Kanomace/WiFi-servo-controller/Cloud Server/MQTTX_setting/Example.png

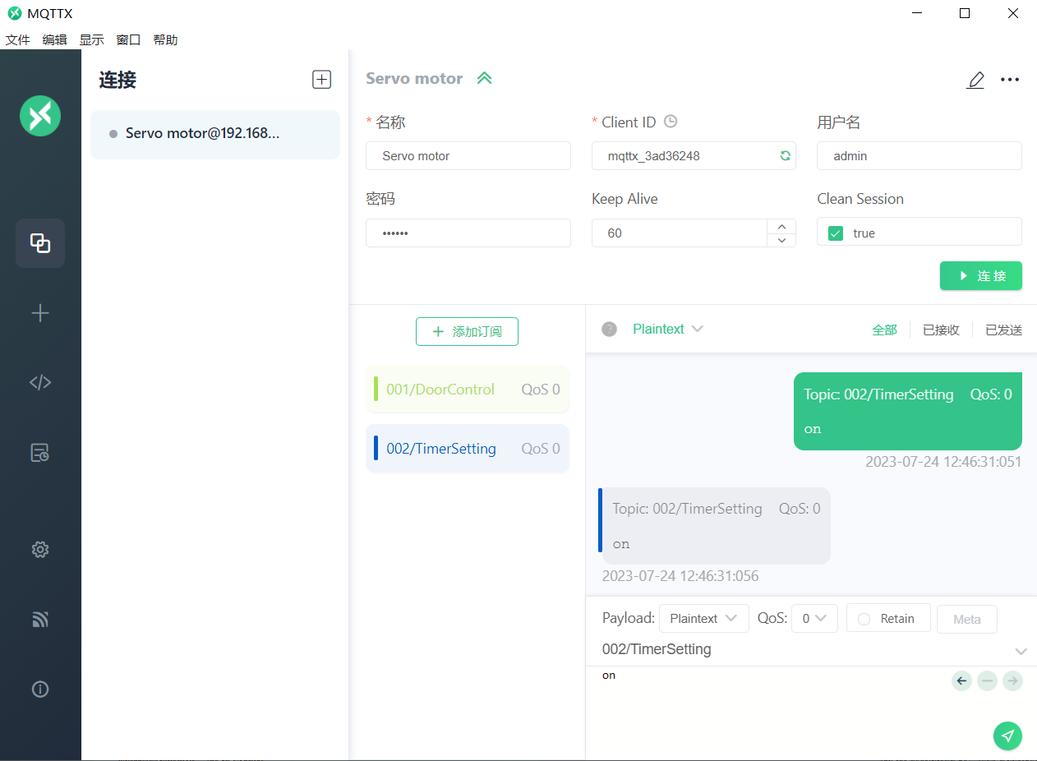
Cloud Server/MQTTX_setting/Example.png
