Kanomace/WiFi-servo-controller/Hardware/BOM_V1_2023-08-09.xlsx

No. | Quantity | Comment | Designator | Footprint | Value | Manufacturer Part | Manufacturer | Supplier Part | Supplier | LCSC Price
1 | 2 | Value +&apos; &apos;+ Voltage + &apos; &apos; + Type | C1,C5 | CAPC1608[0603]S-N | 100nF
2 | 1 | Value +&apos; &apos;+ Voltage + &apos; &apos; + Type | C2 | CAP-E-S 6.3 | 220uF
3 | 1 | Value +&apos; &apos;+ Voltage + &apos; &apos; + Type | C3 | CAPC3216[1206]S | 47uF
4 | 1 | Value +&apos; &apos;+ Voltage + &apos; &apos; + Type | C4 | CAP-E-S 6.3 | 100uF
5 | 1 | Value +&apos; &apos;+ Voltage + &apos; &apos; + Type | C6 | CAPC3216[1206]S | 4.7uF
6 | 1 | Value +&apos; &apos;+ Voltage + &apos; &apos; + Type | C7 | CAPC1608[0603]S-N | 4.7nF
7 | 2 | 10uF | C17,C20 | C0805 | 10uF | GRM21BR61H106KE43L | muRata(村田) | C440198 | LCSC | 0.489247
8 | 2 | 104 | C18,C19 | C0603
9 | 2 | SS54 | D1,D4 | SMA-L[DO-214AC] | SS54
10 | 1 | SS14 | D2 | SOD-123FL_L2.8-W1.8-LS3.7-RD |  | SS14 | KUU | C2909920 | LCSC | 0.085868
11 | 2 | LED | D3,D8 | LED-0805R
12 | 1 | 1N4007 | D7 | SOD-123-L
13 | 2 | TSA343G00-250J2 | EN1,EN2 | SW-SMD_L4.0-W2.9-LS5.0 |  | TSA343G00-250J2 | BRIGHT(博瑞泰) | C354946 | LCSC | 0.309749
14 | 1 | PZ254V-11-08P | H3 | HDR-TH_8P-P2.54-V-M |  | PZ254V-11-08P | XFCN(兴飞) | C492407 | LCSC | 0.249309
15 | 3 | PZ254V-11-03P | H4,H5,H6 | HDR-TH_3P-P2.54-V-M |  | PZ254V-11-03P | XFCN(兴飞) | C2937625 | LCSC | 0.101746
16 | 1 | PZ254V-11-04P | H7 | HDR-TH_4P-P2.54-V-M |  | PZ254V-11-04P | XFCN(兴飞) | C2691448 | LCSC | 0.135871
17 | 1 | Value + &apos; &apos; + Imax | L1 | 0630 TPC 7*7*3 | 4.7uH
18 | 1 | WS2812B-V5/W | LED2 | LED-SMD_L5.0-W5.0-P3.20-LS5.4-TL |  | WS2812B-V5/W | worldsemi | C2874885 | LCSC | 0.681617
19 | 2 | S8050 | Q1,Q2 | SOT-23-3_L2.9-W1.3-P1.90-LS2.4-BR |  | S8050 | WPMtek(维攀微) | C2688231 | LCSC | 0.068462
20 | 1 | AO3402 | Q3 | SOT-23
21 | 1 | Value+&apos; &apos;+Tolerance | R1 | RESC1608[0603]S-N | 51K
22 | 1 | Value+&apos; &apos;+Tolerance | R2 | RESC1608[0603]S-N | 4.7K
23 | 1 | Value+&apos; &apos;+Tolerance | R3 | RESC1608[0603]S-N | 1.5K
24 | 1 | Value+&apos; &apos;+Tolerance | R4 | RESC1608[0603]S-N | 200K
25 | 1 | Value+&apos; &apos;+Tolerance | R5 | RESC1608[0603]S-N | 10K
26 | 1 | Value+&apos; &apos;+Tolerance | R6 | RESC1608[0603]S-N | 20K
27 | 1 | 0Ω | R8 | R0603 | 0Ω | 0603WAF0000T5E | UNI-ROYAL(厚声) | C21189 | LCSC | 0.006582
28 | 1 | 4.7kΩ | R9 | R0603 | 4.7kΩ | 0603WAF4701T5E | UNI-ROYAL(厚声) | C23162 | LCSC | 0.006586
29 | 4 | 1kΩ | R10,R11,R28,R35 | R0603 | 1kΩ | 0603WAF1001T5E | UNI-ROYAL(厚声) | C21190 | LCSC | 0.00351
30 | 4 | 10kΩ | R24,R25,R26,R27 | R0603 | 10kΩ | 0603WAF1002T5E | UNI-ROYAL(厚声) | C25804 | LCSC | 0.005483
31 | 1 | Value+&apos; &apos;+Tolerance | R34 | RESC1608[0603]S-N | 100R
32 | 1 | RELAY | RELAY1 | RELAY-15x10x12
33 | 1 | KH-TYPE-C-16P | TYPE-C1 | USB-C-SMD_KH-TYPE-C-16P |  | KH-TYPE-C-16P | kinghelm(金航标) | C709357 | LCSC | 0.511
34 | 1 | SP1N28STER | U2 | SOP-8E | SP1N28STER
35 | 1 | AMS1117-3.3 | U3 | SOT-89-3_L4.5-W2.5-P1.50-LS4.2-BR |  | AMS1117-3.3 | Slkor(萨科微) | C880752 | LCSC | 0.27159
36 | 1 | CP2102 | U7 | WQFN-28_L5.0-W5.0-P0.50-BL-EP3.2 |  | CP2102 | SILICON LABS(芯科) | C6568 | LCSC | 13.5
37 | 1 | ESP32-WROOM-32D | U8 | WIFIM-SMD_ESP32-WROOM-32D |  | ESP32-WROOM-32D |  | C503588 | LCSC
38 | 1 | 7.2kΩ | U9 | R0603 | 7.2kΩ | AR03FTDX7201NA | Viking(光颉) | C2924153 | LCSC | 0.082603
39 | 2 | KF/WJ/DG 30x connecter | 端子1,端子2 | KF/WJ/DG 301-2p-5.0mm
