Kanomace/WiFi-servo-controller/Cloud Server/MQTTX_setting/个人热点版本.xlsx

id | clientId | name | clean | protocol | host | port | keepalive | connectTimeout | reconnect | reconnectPeriod | username | password | path | certType | ssl | mqttVersion | unreadMessageCount | clientIdWithTime | parentId | orderId | rejectUnauthorized | ca | cert | key | isCollection | createAt | updateAt | sessionExpiryInterval | receiveMaximum | maximumPacketSize | topicAliasMaximum | requestResponseInformation | requestProblemInformation | userProperties | authenticationMethod | authenticationData | pushPropsPayloadFormatIndicator | pushPropsMessageExpiryInterval | pushPropsTopicAlias | pushPropsResponseTopic | pushPropsCorrelationData | pushPropsUserProperties | pushPropsSubscriptionIdentifier | pushPropsContentType | messages | subscriptions | will | properties
01d8d247-3361-47cc-b64b-676d72b897c0 | mqttx_3ad36248 | Servo motor | TRUE | mqtt | 192.168.202.86 | 1883 | 60 | 10 | FALSE | 4000 | admin | public | /mqtt |  | FALSE | 3.1.1 | 0 | FALSE |  |  | TRUE |  |  |  | FALSE | 2023-07-24 | 2023-08-10 | 0 |  |  |  |  |  |  |  |  |  |  |  |  |  |  |  |  | [{"id":"message_010baf29-1d7a-4095-9a20-c25273d7eb77","createAt":"2023-07-24 09:51:23:920","out":true,"payload":"{\n \"msg\": \"hello\"\n}","qos":0,"retain":false,"topic":"/topic/qos1","meta":null,"payloadFormatIndicator":null,"messageExpiryInterval":null,"topicAlias":null,"responseTopic":null,"correlationData":null,"userProperties":null,"subscriptionIdentifier":null,"contentType":null,"connectionId":"01d8d247-3361-47cc-b64b-676d72b897c0","properties":{"id":"message_010baf29-1d7a-4095-9a20-c25273d7eb77","createAt":"2023-07-24 09:51:23:920","out":true,"payload":"{\n \"msg\": \"hello\"\n}","qos":0,"retain":false,"topic":"/topic/qos1","meta":null,"payloadFormatIndicator":null,"messageExpiryInterval":null,"topicAlias":null,"responseTopic":null,"correlationData":null,"subscriptionIdentifier":null,"contentType":null,"connectionId":"01d8d247-3361-47cc-b64b-676d72b897c0"}},{"id":"message_b9f6697a-188c-4174-be61-1b66a67af96d","createAt":"2023-07-24 09:51:24:403","out":true,"payload":"{\n \"msg\": \"hello\"\n}","qos":0,"retain":false,"topic":"/topic/qos1","meta":null,"payloadFormatIndicator":null,"messageExpiryInterval":null,"topicAlias":null,"responseTopic":null,"correlationData":null,"userProperties":null,"subscriptionIdentifier":null,"contentType":null,"connectionId":"01d8d247-3361-47cc-b64b-676d72b897c0","properties":{"id":"message_b9f6697a-188c-4174-be61-1b66a67af96d","createAt":"2023-07-24 09:51:24:403","out":true,"payload":"{\n \"msg\": \"hello\"\n}","qos":0,"retain":false,"to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 | [{"id":"scription_5e358d23-725f-4dc8-baea-258029589950","topic":"002/TimerSetting","qos":0,"disabled":false,"alias":"","retain":false,"nl":false,"rap":false,"rh":0,"subscriptionIdentifier":null,"userProperties":null,"color":"#005DC6","createAt":"2023-07-24T02:25:39.056Z","connectionId":"01d8d247-3361-47cc-b64b-676d72b897c0"},{"id":"scription_cec65b79-d5ad-48da-9c36-22f6f5641e1f","topic":"001/DoorControl","qos":0,"disabled":false,"alias":"","retain":false,"nl":false,"rap":false,"rh":0,"subscriptionIdentifier":null,"userProperties":null,"color":"#A9E057","createAt":"2023-07-24T02:25:39.056Z","connectionId":"01d8d247-3361-47cc-b64b-676d72b897c0"}] | {"id":"c2b9f3c8-17bf-4f18-9b59-da8d00c9fbeb","lastWillTopic":"","lastWillPayload":"","lastWillQos":0,"lastWillRetain":false,"willDelayInterval":null,"payloadFormatIndicator":null,"messageExpiryInterval":null,"contentType":"","responseTopic":null,"correlationData":null,"userProperties":null,"properties":{"willDelayInterval":null,"payloadFormatIndicator":null,"messageExpiryInterval":null,"contentType":"","responseTopic":null,"correlationData":null,"userProperties":null}} | {"sessionExpiryInterval":0,"receiveMaximum":null,"maximumPacketSize":null,"topicAliasMaximum":null,"requestResponseInformation":null,"requestProblemInformation":null,"authenticationMethod":null}
