Kanomace/WiFi-servo-controller/Hardware/SCH_Schematic_V1_2023-08-09.pdf

ESP32 | Type-C | CP2102 | 一键下载 | Key

# NC 22 CTS 23 RTS 24 RXD 25 TXD 26 DSR 27 DTR 28 EP 29

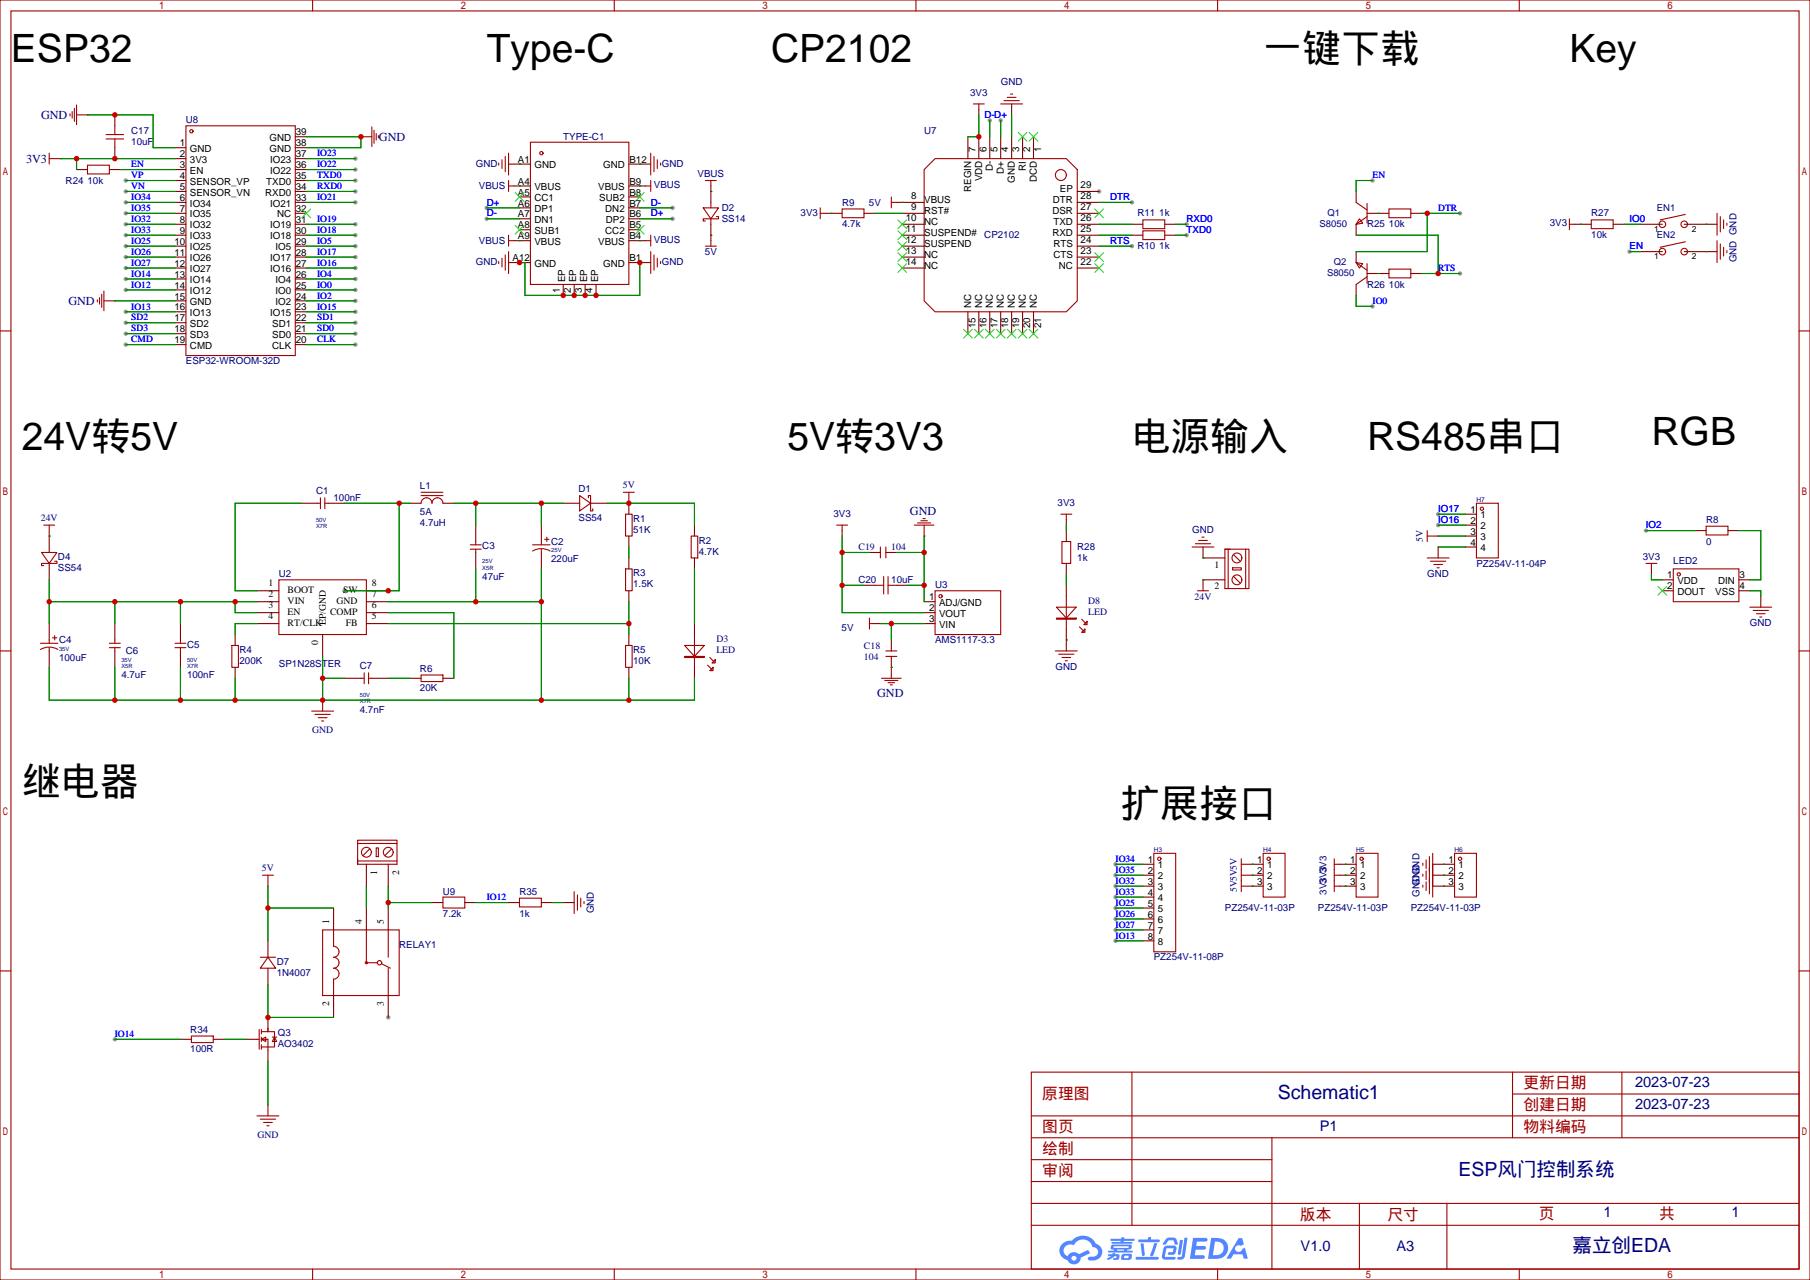
[picture p4: page 1]
