Kanomace/WiFi-servo-controller/Hardware/PCB_V1_2023-08-09.pdf

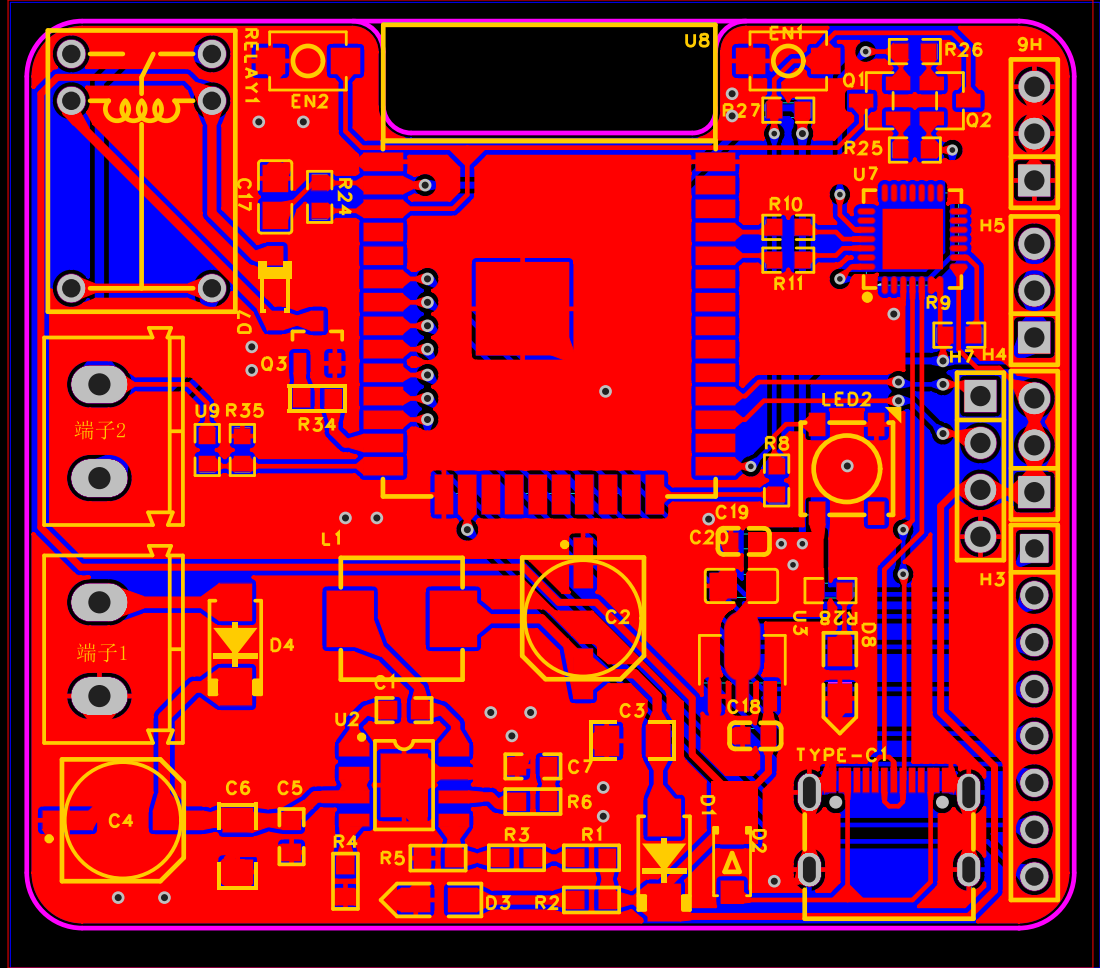
[picture p5: page 1]
