Kanomace/WiFi-servo-controller/(commit log)

2023-08-09 An ESP32 connection to MQTT routine
2023-08-09 Some existing engineering documents
    [BOM_V1_2023-08-09.xlsx, data.xlsx]
2023-08-10 添加了自动重连功能
2023-08-10 添加了个人热点服务器版本
    [WIFI版本.xlsx, 个人热点版本.xlsx]
2023-08-10 添加了eeprom定时设置与读取
2023-08-13 添加了订阅修改定时器功能
2023-08-14 添加Readme
2023-08-16 添加了继电器控制
2023-09-01 增添网口通讯
2023-10-24 程序执行流程
2023-10-24 更新图片大小
2023-10-24 修改WiFi信息
